alogd/open-rf-positioner/docs/README.md

# Documentation

- `images/` — photos, CAD renders, block diagram, wiring diagram.
- `characterization/` — angular repeatability and OTA validation results.
