alogd/open-rf-positioner/docs/images/pinion_gear_without_protector.png

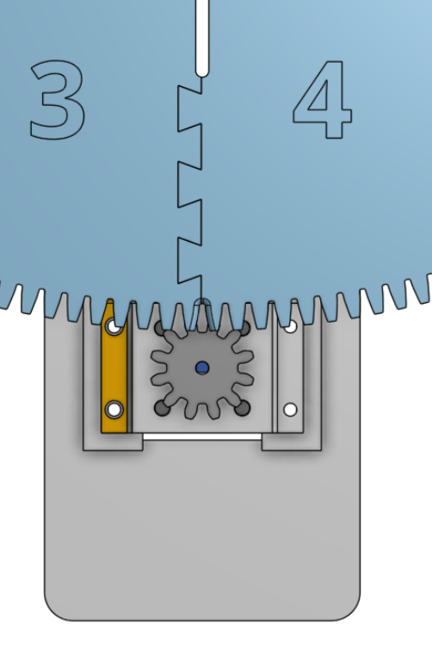
docs/images/pinion_gear_without_protector.png
