alogd/open-rf-positioner/docs/images/platform_view2.png

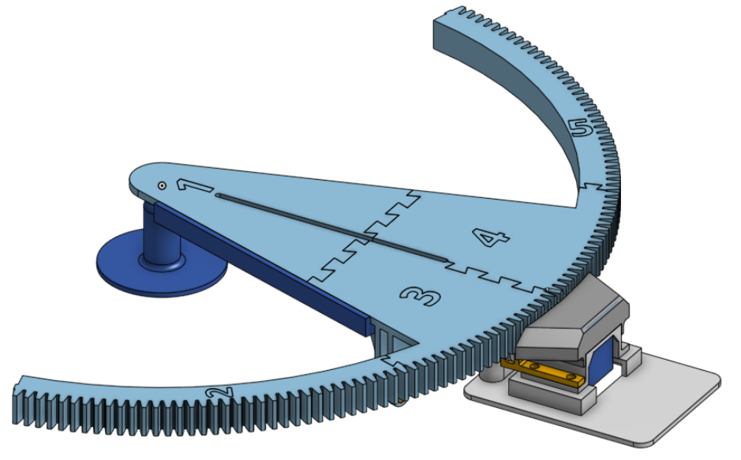
docs/images/platform_view2.png
