alogd/open-rf-positioner/hardware/bom/bom.csv

category | component | specification | qty | unit_cost_eur | Reference part link
Electronics and motion | Microcontroller | ESP32-H2 dev module | 1 | 5 | https://grobotronics.com/waveshare-esp32-h2-zero.html
Electronics and motion | Stepper motor | NEMA 17, 200 steps/rev, 2.8 kg·cm | 1 | 13 | https://grobotronics.com/stepper-motor-42byghw208-2-6kg-cm.html
Electronics and motion | Stepper driver | A4988 | 1 | 4 | https://www.amazon.com/KEAcvise-5-Pack-A4988-Stepper-Driver/dp/B0F93ZXLGW
Electronics and motion | Limit switch | mechanical, long lever | 2 | 2 | https://www.amazon.com/Micro-Limit-Switch-Hinge-250VAC/dp/B0DRBWRKLQ
Electronics and motion | Power supply | 12V / 2A | 1 | 6 | https://grobotronics.com/power-supply-12vdc-2a-psu-1602.html
Electronics and motion | Wiring, connectors |  |  | 2
Mechanical and 3D-printed (PLA) | PLA filament | 1000 g | 1 | 11 | https://www.amazon.co.uk/eSUN-Filament-Dimensional-Accuracy-Printers/dp/B0CR1DBBFM
Mechanical and 3D-printed (PLA) | Bearings | 672ZZ (22 outer_d x 7 inner_d x 7mm width) | 7 | 1 | https://www.amazon.co.uk/Swpeet-Bearings-Assortment-Miniature-Shielded/dp/B0G23P63SX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
Mechanical and 3D-printed (PLA) | Fasteners | M5 bolts /M3 bolts(motor), screws |  | 3
 | TOTAL in EUR |  |  | 55
