alogd/open-rf-positioner/hardware/stl/Pinion_gear_cover.stl

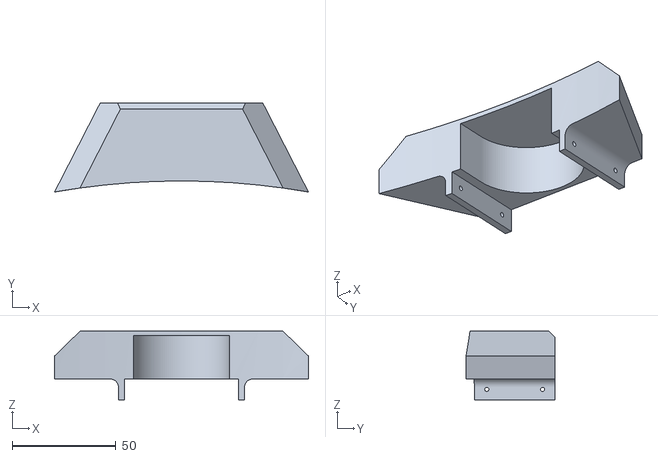
[picture p5: CAD file, 2026-10-18]
hardware/stl/Pinion_gear_cover.stl
122.3 x 42.9 x 33.0
