alogd/open-rf-positioner/hardware/stl/Moving_section_3.stl

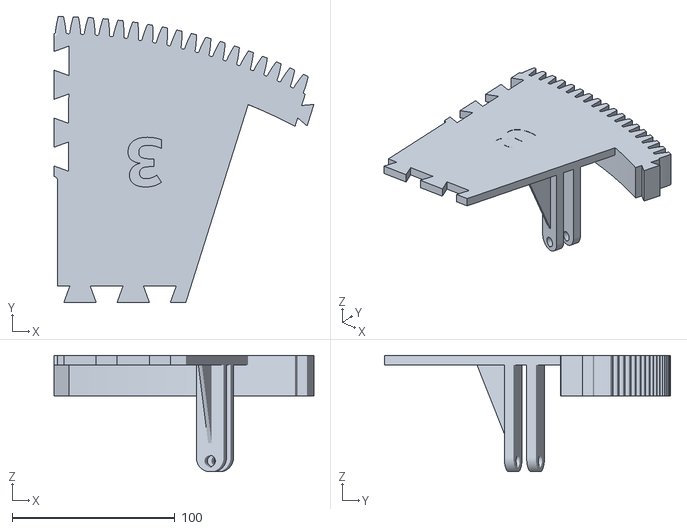
[picture p6: CAD file, 2026-10-18]
hardware/stl/Moving_section_3.stl
159.8 x 175.9 x 71.6
