alogd/open-rf-positioner/hardware/stl/BearingPin.stl

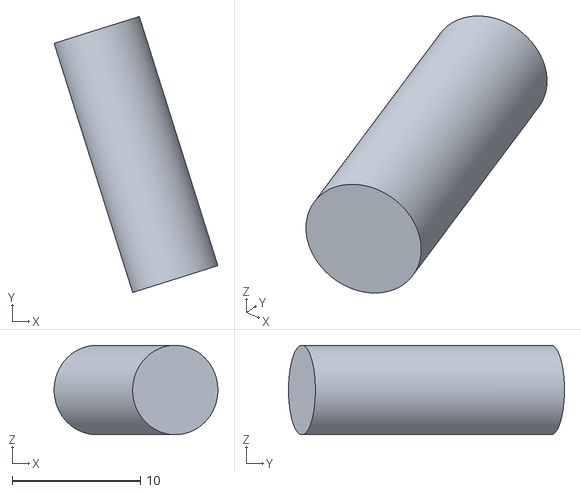
[picture p7: CAD file, 2026-10-18]
hardware/stl/BearingPin.stl
12.8 x 21.6 x 6.98
