alogd/open-rf-positioner/hardware/stl/Bearing.stl

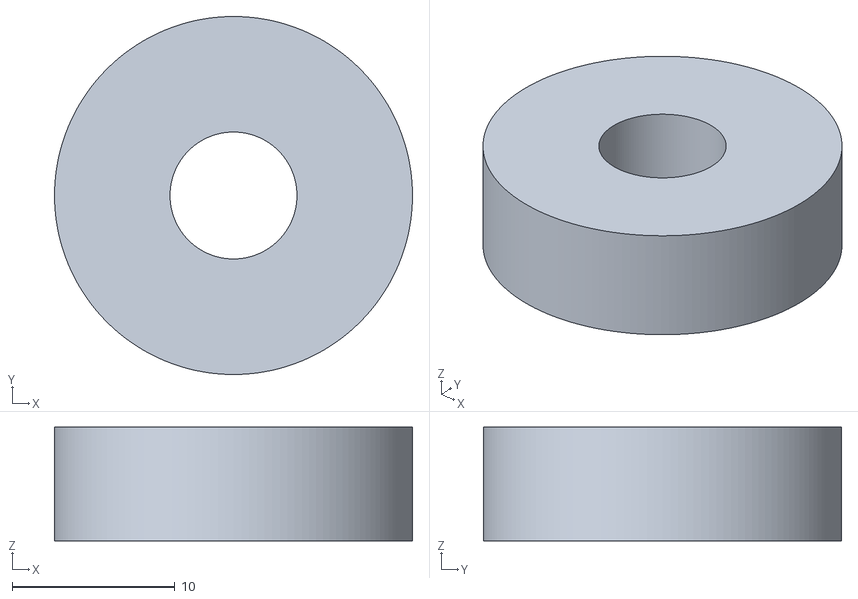
[picture p8: CAD file, 2026-10-18]
hardware/stl/Bearing.stl
22.0 x 22.0 x 7.00
