alogd/open-rf-positioner/hardware/stl/Moving_section_5.stl

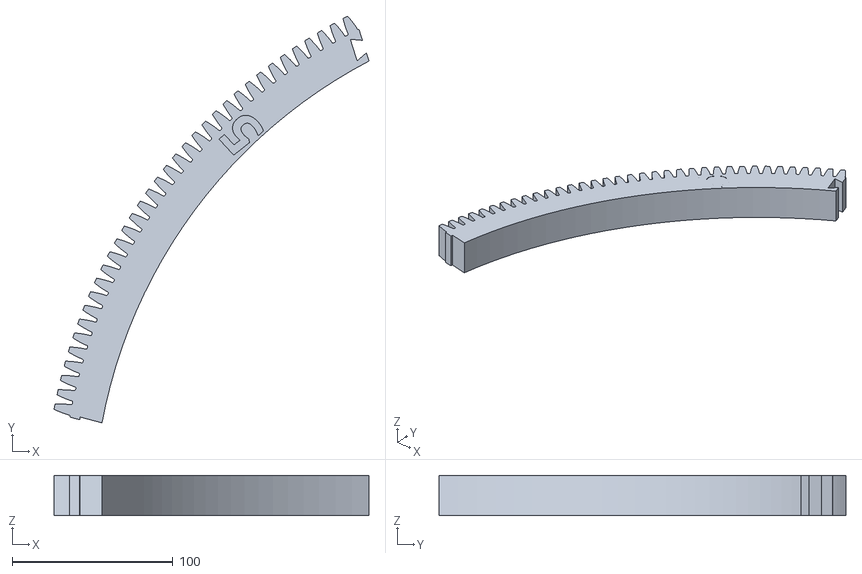
[picture p9: CAD file, 2026-10-18]
hardware/stl/Moving_section_5.stl
195.8 x 252.9 x 25.0
