alogd/open-rf-positioner/hardware/stl/Pinion gear.stl

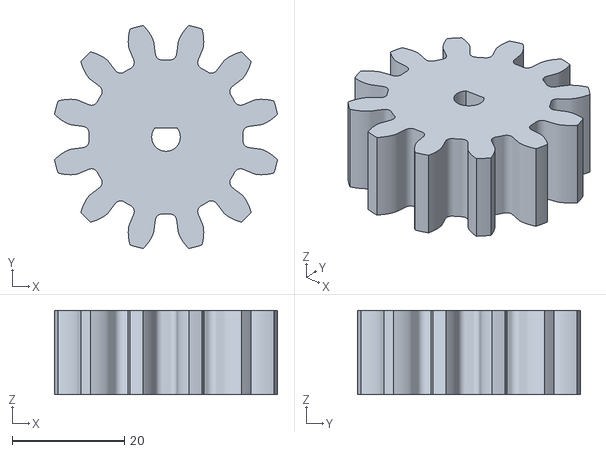
[picture p10: CAD file, 2026-10-18]
hardware/stl/Pinion gear.stl
39.8 x 39.8 x 15.0
