alogd/open-rf-positioner/hardware/stl/Limit_switch_actuator.stl

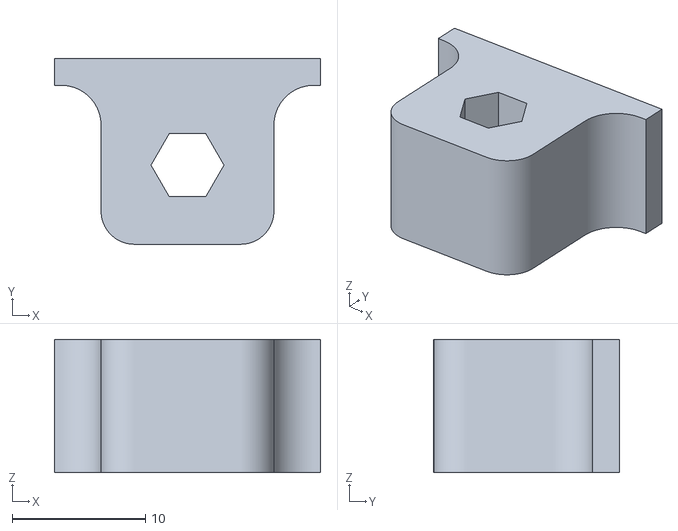
[picture p11: CAD file, 2026-10-18]
hardware/stl/Limit_switch_actuator.stl
20.0 x 13.9 x 10.0
