alogd/open-rf-positioner/hardware/stl/Limit_switch_actuator_cap.stl

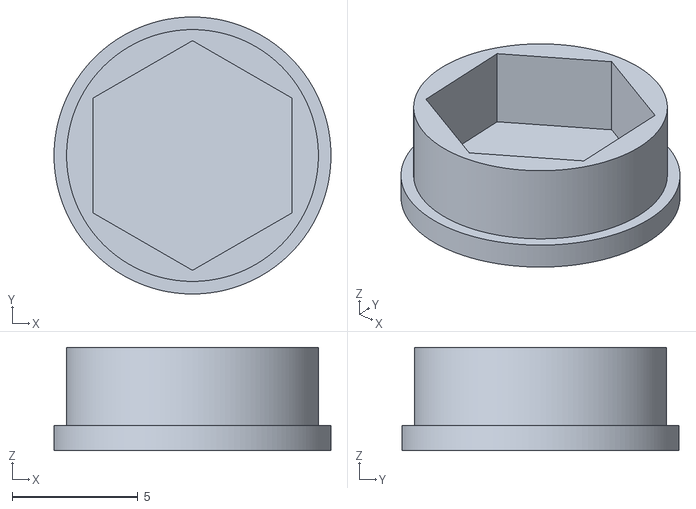
[picture p12: CAD file, 2026-10-18]
hardware/stl/Limit_switch_actuator_cap.stl
11.0 x 11.0 x 4.10
