alogd/open-rf-positioner/hardware/stl/Support_bracket_with_bearing.stl

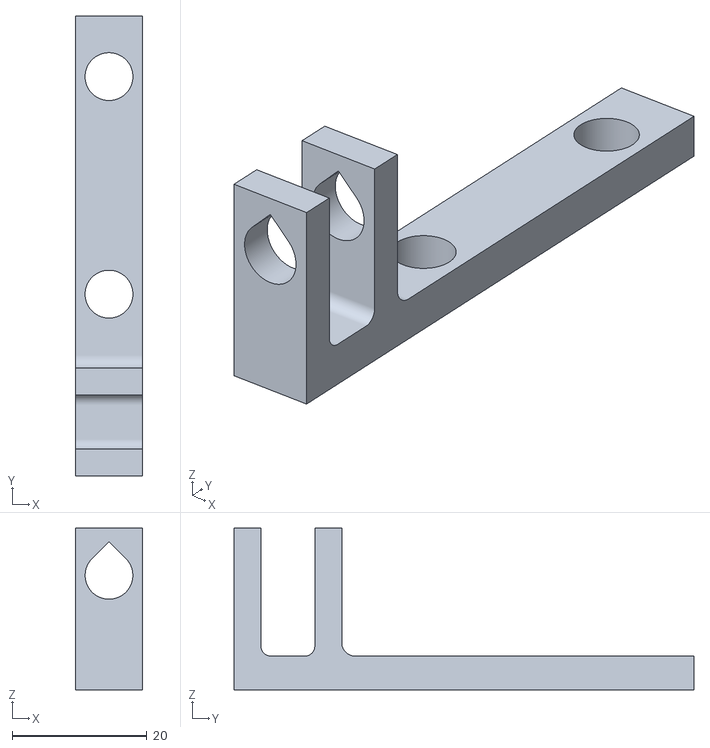
[picture p13: CAD file, 2026-10-18]
hardware/stl/Support_bracket_with_bearing.stl
10.0 x 68.3 x 24.0
