alogd/open-rf-positioner/hardware/stl/Moving_section_1.stl

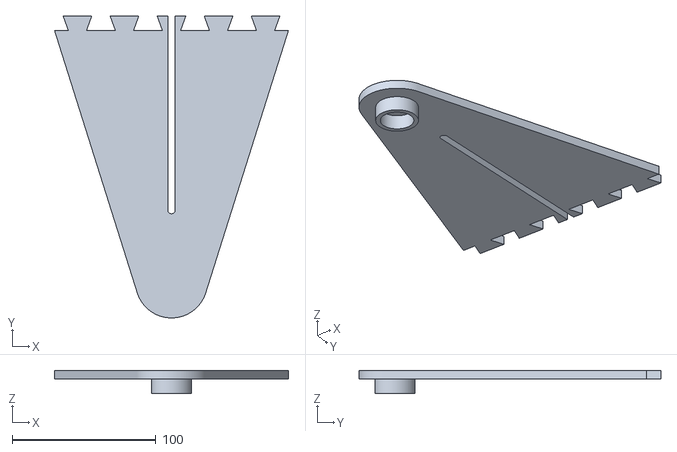
[picture p14: CAD file, 2026-10-18]
hardware/stl/Moving_section_1.stl
162.8 x 210.0 x 16.0
