alogd/open-rf-positioner/hardware/stl/Stationary_base-motor_section.stl

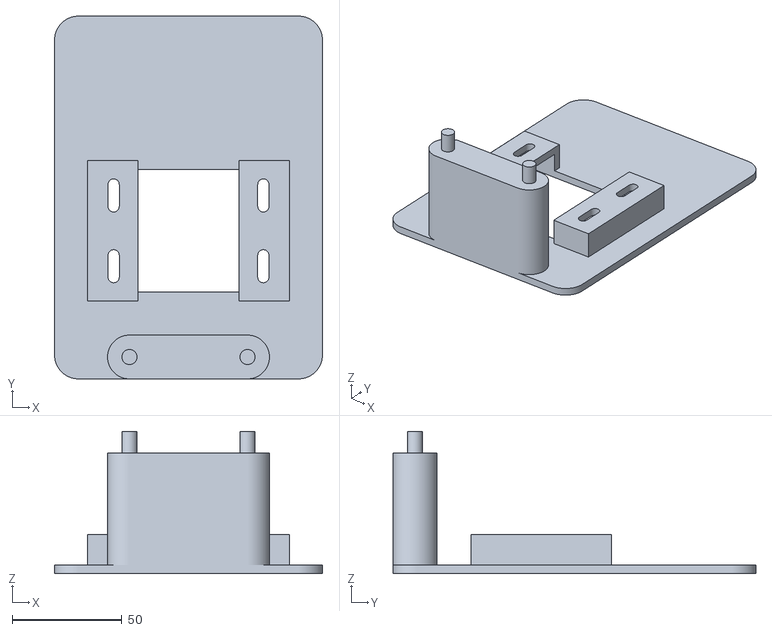
[picture p15: CAD file, 2026-10-18]
hardware/stl/Stationary_base-motor_section.stl
122.3 x 165.6 x 65.0
