alogd/open-rf-positioner/hardware/stl/Front_rotation_axis.stl

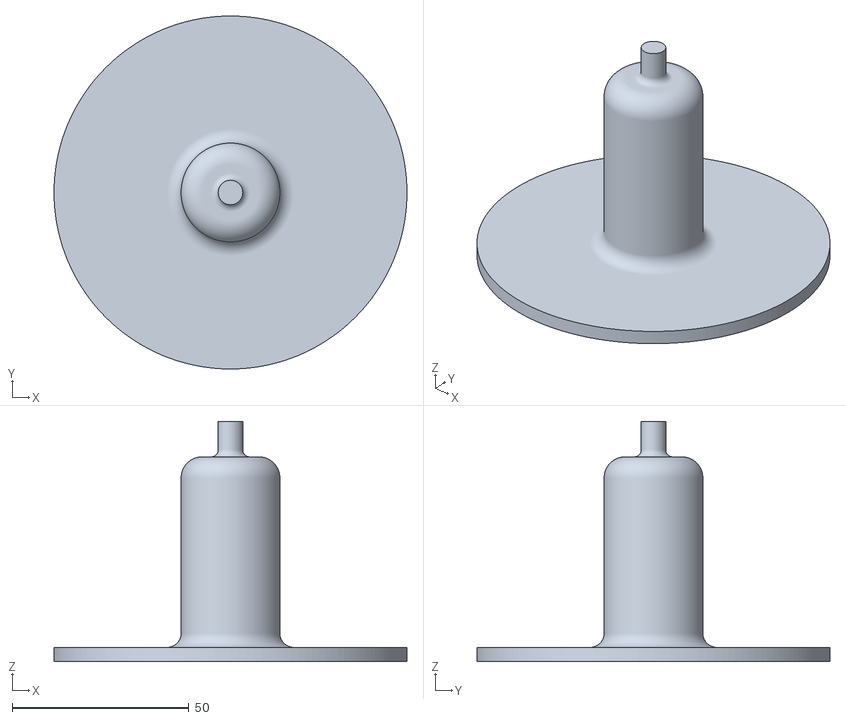
[picture p16: CAD file, 2026-10-18]
hardware/stl/Front_rotation_axis.stl
100.0 x 100.0 x 68.0
