alogd/open-rf-positioner/hardware/stl/Motor_to_base_mount.stl

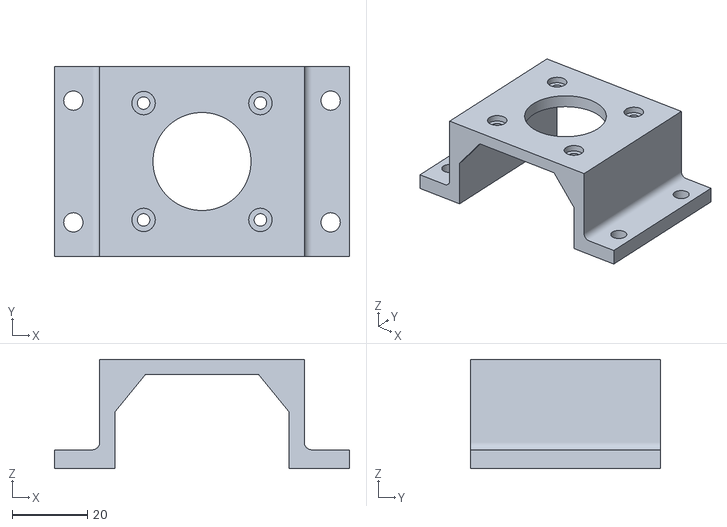
[picture p17: CAD file, 2026-10-18]
hardware/stl/Motor_to_base_mount.stl
78.3 x 50.3 x 29.0
