alogd/open-rf-positioner/hardware/stl/Support_rib_side.stl

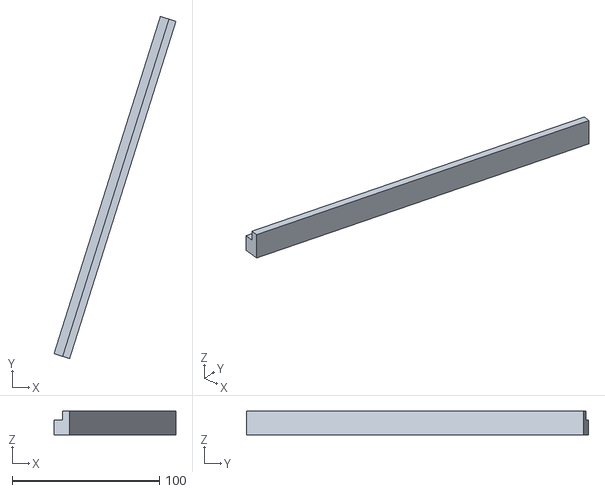
[picture p18: CAD file, 2026-10-18]
hardware/stl/Support_rib_side.stl
82.8 x 232.2 x 16.0
