alogd/open-rf-positioner/hardware/stl/Moving_section_4.stl

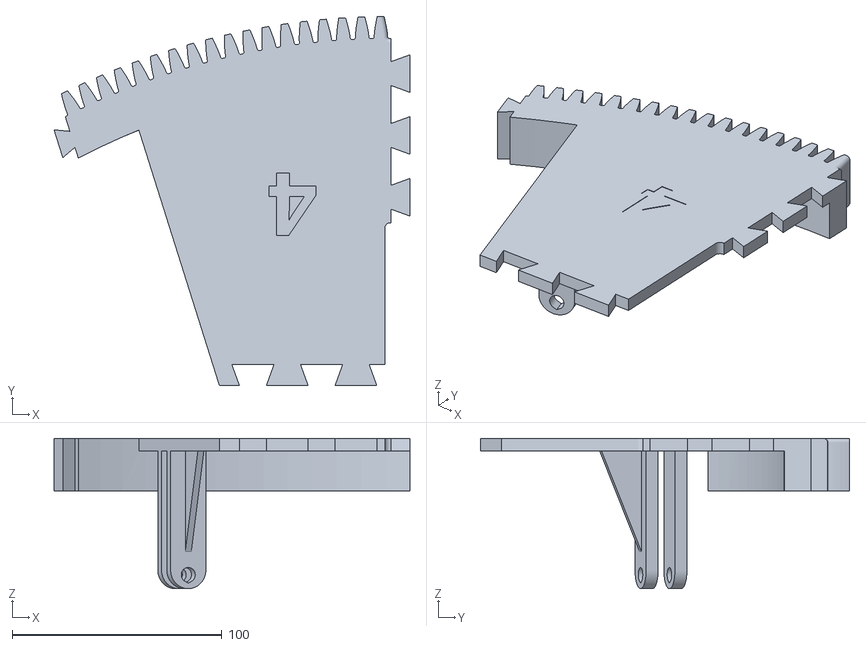
[picture p19: CAD file, 2026-10-18]
hardware/stl/Moving_section_4.stl
169.6 x 175.9 x 71.6
