alogd/open-rf-positioner/hardware/stl/Support_rib_middle.stl

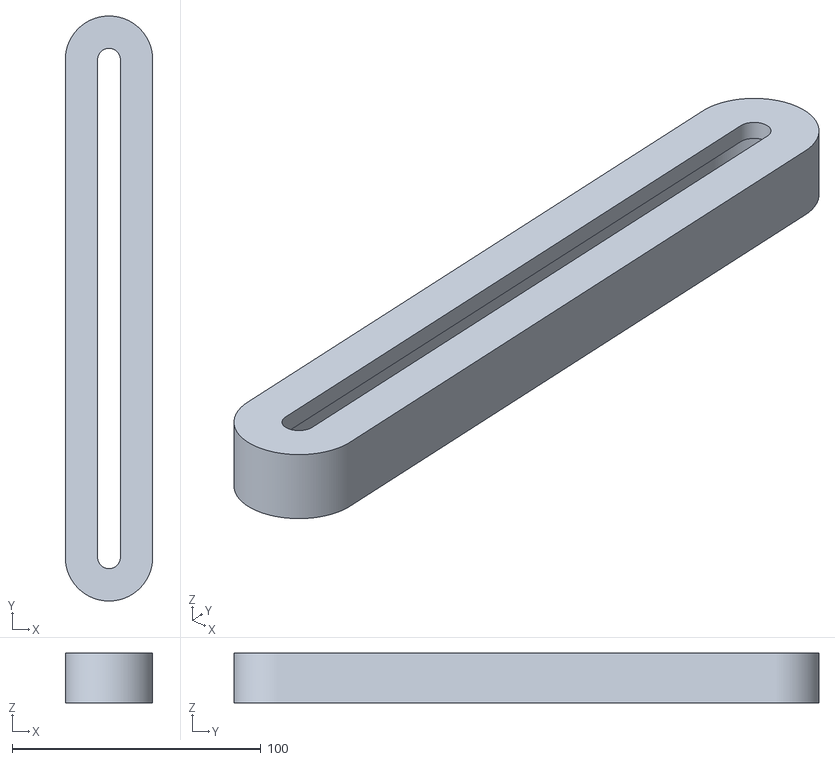
[picture p20: CAD file, 2026-10-18]
hardware/stl/Support_rib_middle.stl
35.1 x 235.1 x 20.0
