alogd/open-rf-positioner/(list of files, cad)

Other CAD files:
hardware/stl/Moving_section_2.stl
