alogd/open-rf-positioner/(commit log)

2026-10-18 First bulk commit
    [Bearing.stl, BearingPin.stl, Front_rotation_axis.stl, Limit_switch_activator_cap.stl, Limit_switch_actuator.stl, Motor_to_base_mount.stl, Moving_section_1.stl, Moving_section_2.stl]
2026-10-19 Repo Cleanup
    [Limit_switch_actuator_cap.stl]
