alogd/open-rf-positioner/docs/images/hardware_on_mini_breadboard.jpg

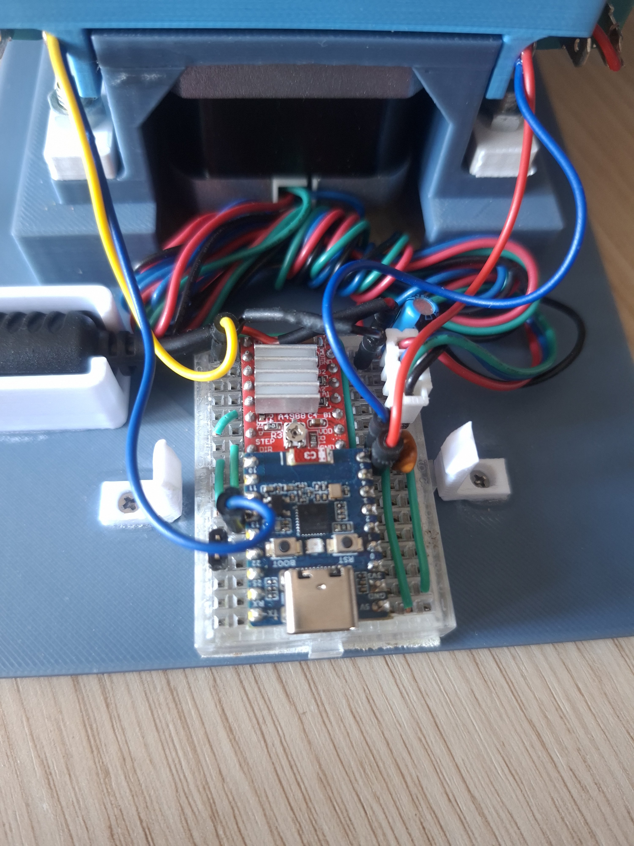
[picture p22: docs/images/hardware_on_mini_breadboard.jpg]
docs/images/hardware_on_mini_breadboard.jpg
