alogd/open-rf-positioner/docs/images/anechoic_2.jpg

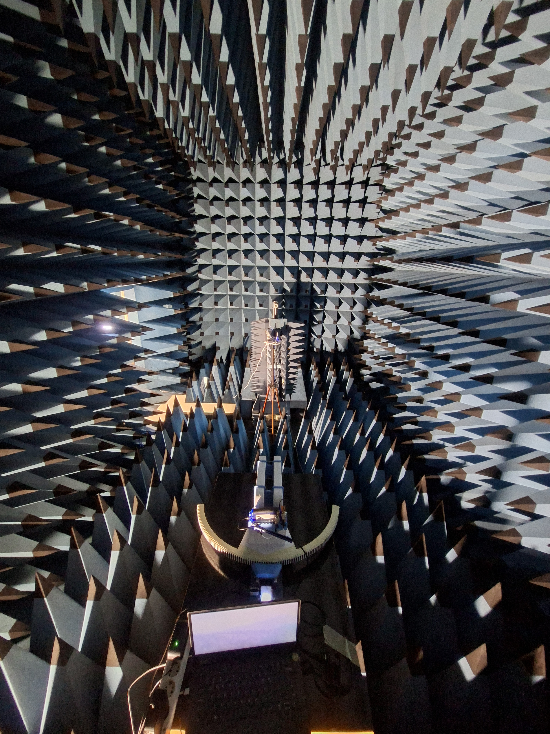
[picture p24: docs/images/anechoic_2.jpg]
docs/images/anechoic_2.jpg
